LinkRetro/SD2GC/kicad/LinkRetro-SD2GC_2.3.kicad_pcb

## KiCad design kicad/LinkRetro-SD2GC_2.3.kicad_pcb (2026-10-22)

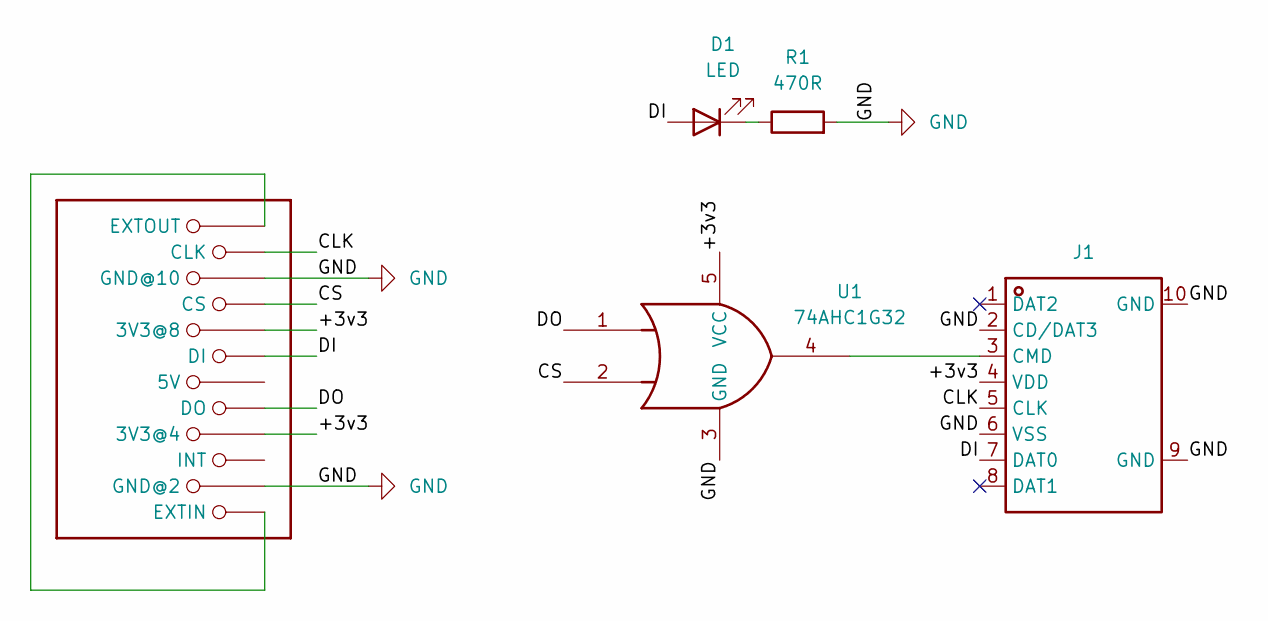
[picture p1: schematic LinkRetro-SD2GC_2.3.kicad_sch]

Parts:
D1: LED; LED_0402_1005Metric_Pad0.77x0.64mm_HandSolder
J1: TF-004; TF-SMD_TF-01A; MANUFACTURER PART TF-004; LCSC PART NAME 拔插式 MicroSD卡(TF卡) 卡座
J2: GC_MEMCARD
R1: 470R; R_0603_1608Metric
U1: 74AHC1G32; SC-74A-5_1.55x2.9mm_P0.95mm

Connections:
/+3v3: J1.4 (VDD), J2.4 (3V3@4), J2.8 (3V3@8), U1.5 (VCC)
/CLK: J1.5 (CLK), J2.11 (CLK)
/CS: J2.9 (CS), U1.2
/DI: D1.2 (A), J1.7 (DAT0), J2.7 (DI)
/DO: J2.5 (DO), U1.1
GND: J1.2 (CD/DAT3), J1.6 (VSS), J1.9 (GND), J1.10 (GND), J2.2 (GND@2), J2.10 (GND@10), R1.2, U1.3 (GND)
unnamed: D1.1 (K), R1.1
unnamed: J1.3 (CMD), U1.4
unnamed: J2.1 (EXTIN), J2.12 (EXTOUT)

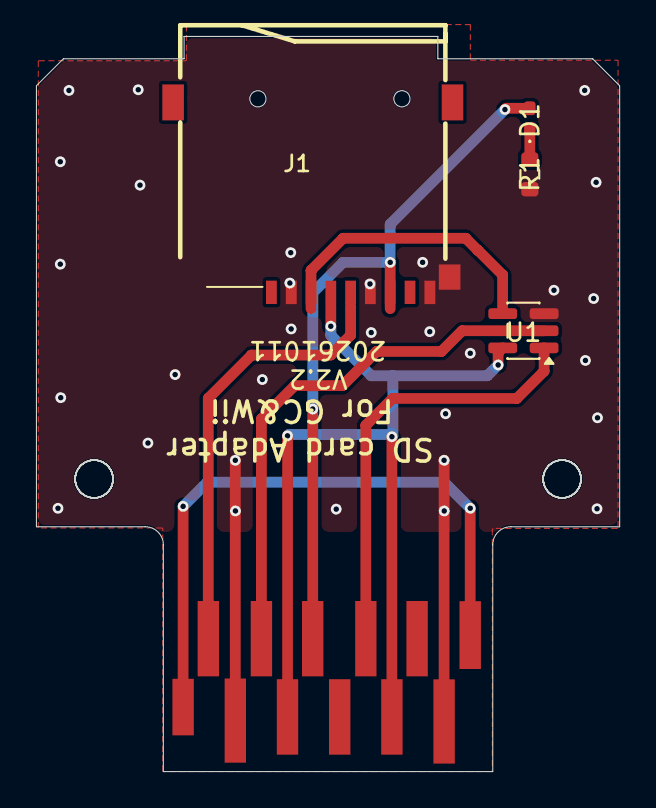
[picture p2: board LinkRetro-SD2GC_2.3.kicad_pcb from above]

Board: 2 copper layers, 32.4 x 40.8 mm, 5 parts (0 on the bottom side), 9 nets.
