LinkRetro/SD2GC/(commit log)

2026-10-22 feat(hw): import LinkRetro SD2GC 2.3 design and fabrication data
    - add KiCad 2.3 schematic, PCB layout and project files
    - add custom footprints in Library.pretty and 3D models in packages3D
    - add Gerber archive LinkRetro-SD2GC-V2.3-20261014.zip
    - replace previous GC2SD 2.0 content of this repository
    [LinkRetro-SD2GC_2.3.kicad_pcb, LinkRetro-SD2GC_2.3.kicad_sch]
2026-10-22 docs(readme): describe the SD2GC 2.3 redesign, enclosure and credits
    - explain the ground-up PCB redesign and the matching custom enclosure
    - document the component set, repository layout, build and usage notes
    - credit Extrems (SD2SP2) and the GC2SD open-source authors
